johnkok/mpm/PCB/MPM/pm.kicad_pcb

## KiCad design PCB/MPM/pm.kicad_pcb (2024-08-20)

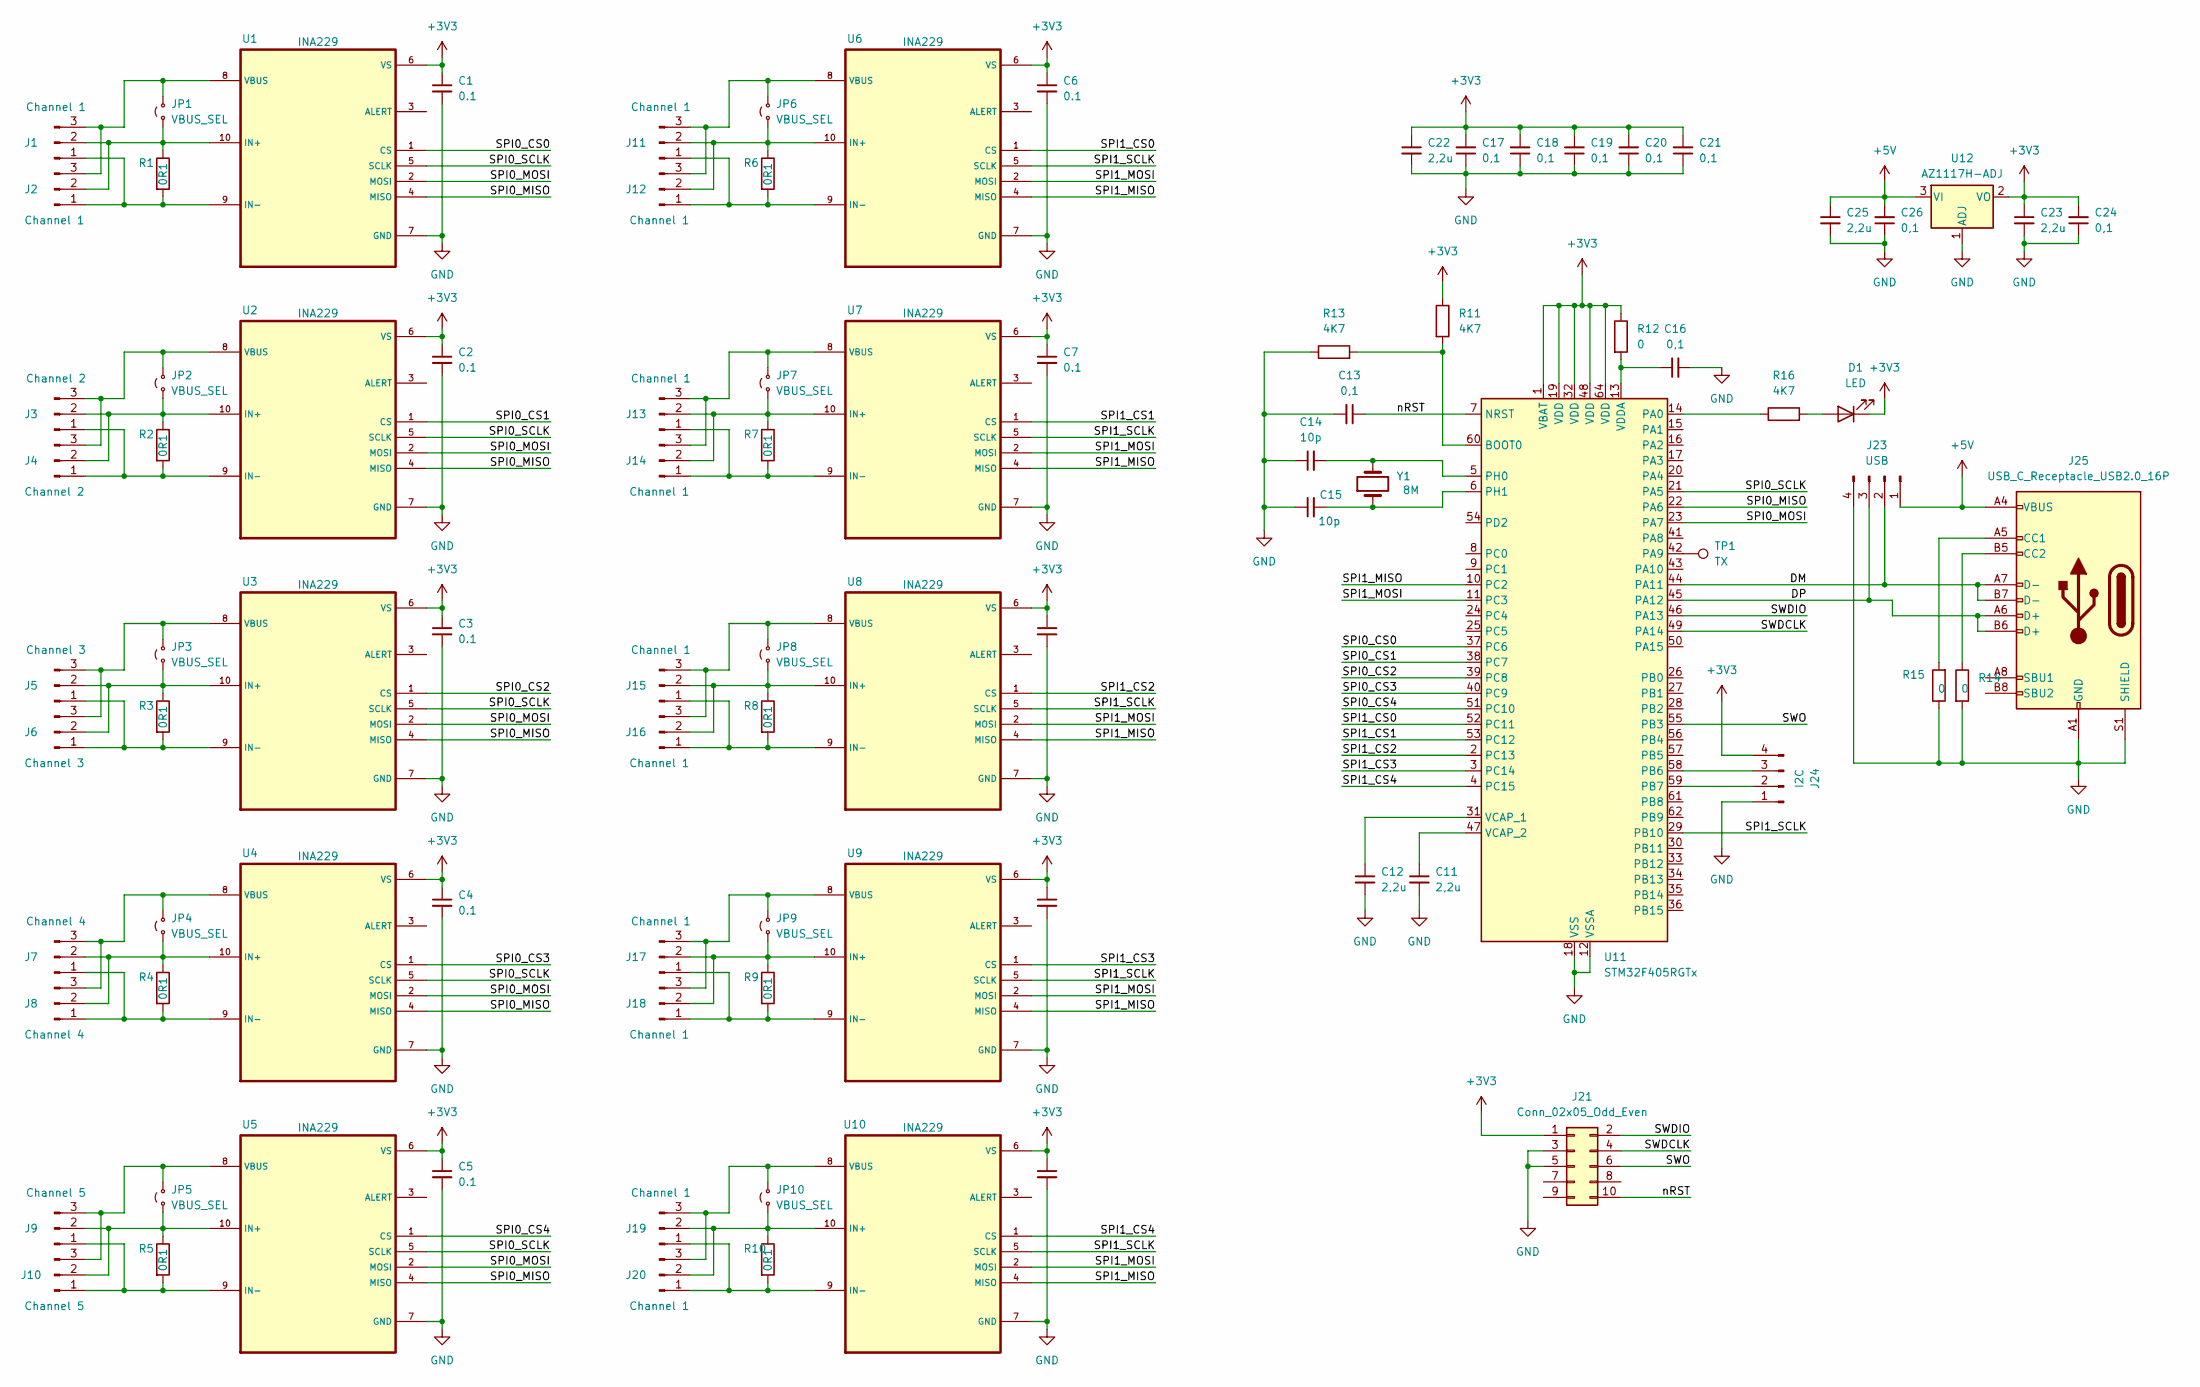
[picture p1: schematic pm.kicad_sch]

Parts:
C1, C2, C3, C4, C5, C6, C7, C8, C9, C10: 0.1; C_0603_1608Metric_Pad1.08x0.95mm_HandSolder
C11, C12, C22, C23, C25: 2,2u; C_0805_2012Metric_Pad1.18x1.45mm_HandSolder
C13, C16, C17, C18, C19, C20, C21, C24, C26: 0,1; C_0603_1608Metric_Pad1.08x0.95mm_HandSolder
C14, C15: 10p; C_0603_1608Metric_Pad1.08x0.95mm_HandSolder
D1: LED; LED_0603_1608Metric
J1, J11, J13, J15, J17, J19: Channel 1; PinHeader_1x03_P2.54mm_Vertical
J2, J12, J14, J16, J18, J20: Channel 1; PhoenixContact_MCV_1,5_3-G-5.08_1x03_P5.08mm_Vertical
J3: Channel 2; PinHeader_1x03_P2.54mm_Vertical
J4: Channel 2; PhoenixContact_MCV_1,5_3-G-5.08_1x03_P5.08mm_Vertical
J5: Channel 3; PinHeader_1x03_P2.54mm_Vertical
J6: Channel 3; PhoenixContact_MCV_1,5_3-G-5.08_1x03_P5.08mm_Vertical
J7: Channel 4; PinHeader_1x03_P2.54mm_Vertical
J8: Channel 4; PhoenixContact_MCV_1,5_3-G-5.08_1x03_P5.08mm_Vertical
J9: Channel 5; PinHeader_1x03_P2.54mm_Vertical
J10: Channel 5; PhoenixContact_MCV_1,5_3-G-5.08_1x03_P5.08mm_Vertical
J21: Conn_02x05_Odd_Even; PinHeader_2x05_P2.54mm_Vertical
J23: USB; PinHeader_1x04_P2.54mm_Vertical
J24: I2C; PinHeader_1x04_P2.54mm_Vertical
J25: USB_C_Receptacle_USB2.0_16P; USB_C_Receptacle_GCT_USB4105-xx-A_16P_TopMnt_Horizontal
JP1, JP2, JP3, JP4, JP5, JP6, JP7, JP8, JP9, JP10: VBUS_SEL; PinHeader_1x02_P2.54mm_Vertical
R1, R2, R3, R4, R5, R6, R7, R8, R9, R10: 0R1; R_1206_3216Metric_Pad1.30x1.75mm_HandSolder
R11, R13, R16: 4K7; R_0603_1608Metric_Pad0.98x0.95mm_HandSolder
R12, R14, R15: 0; R_0603_1608Metric_Pad0.98x0.95mm_HandSolder
TP1: TX; TestPoint_Loop_D1.80mm_Drill1.0mm_Beaded
U1, U2, U3, U4, U5, U6, U7, U8, U9, U10: INA229; VSSOP-10_3x3mm_P0.5mm
U11: STM32F405RGTx; LQFP-64_10x10mm_P0.5mm
U12: AZ1117H-ADJ; SOT-223-3_TabPin2
Y1: 8M; Crystal_HC18-U_Vertical

Connections:
+3V3: C1.1, C2.1, C3.1, C4.1, C5.1, C6.1, C7.1, C8.1, C9.1, C10.1, C17.2, C18.2, C19.2, C20.2, C21.2, C22.1, C23.1, C24.2, D1.1 (K), J21.1, J24.4, R11.1, R12.1, U1.6 (VS), U2.6 (VS), U3.6 (VS), U4.6 (VS), U5.6 (VS), U6.6 (VS), U7.6 (VS), U8.6 (VS), U9.6 (VS), U10.6 (VS), U11.1 (VBAT), U11.19 (VDD), U11.32 (VDD), U11.48 (VDD), U11.64 (VDD), U12.2 (VO)
+5V: C25.1, C26.2, J23.1, J25.A4 (VBUS), J25.A9 (VBUS), J25.B4 (VBUS), J25.B9 (VBUS), U12.3 (VI)
/DM: J23.2, J25.A7 (D-), J25.B7 (D-), U11.44 (PA11)
/DP: J23.3, J25.A6 (D+), J25.B6 (D+), U11.45 (PA12)
/SPI0_CS0: U1.1 (CS), U11.37 (PC6)
/SPI0_CS1: U2.1 (CS), U11.38 (PC7)
/SPI0_CS2: U3.1 (CS), U11.39 (PC8)
/SPI0_CS3: U4.1 (CS), U11.40 (PC9)
/SPI0_CS4: U5.1 (CS), U11.51 (PC10)
/SPI0_MISO: U1.4 (MISO), U2.4 (MISO), U3.4 (MISO), U4.4 (MISO), U5.4 (MISO), U11.22 (PA6)
/SPI0_MOSI: U1.2 (MOSI), U2.2 (MOSI), U3.2 (MOSI), U4.2 (MOSI), U5.2 (MOSI), U11.23 (PA7)
/SPI0_SCLK: U1.5 (SCLK), U2.5 (SCLK), U3.5 (SCLK), U4.5 (SCLK), U5.5 (SCLK), U11.21 (PA5)
/SPI1_CS0: U6.1 (CS), U11.52 (PC11)
/SPI1_CS1: U7.1 (CS), U11.53 (PC12)
/SPI1_CS2: U8.1 (CS), U11.2 (PC13)
/SPI1_CS3: U9.1 (CS), U11.3 (PC14)
/SPI1_CS4: U10.1 (CS), U11.4 (PC15)
/SPI1_MISO: U6.4 (MISO), U7.4 (MISO), U8.4 (MISO), U9.4 (MISO), U10.4 (MISO), U11.10 (PC2)
/SPI1_MOSI: U6.2 (MOSI), U7.2 (MOSI), U8.2 (MOSI), U9.2 (MOSI), U10.2 (MOSI), U11.11 (PC3)
/SPI1_SCLK: U6.5 (SCLK), U7.5 (SCLK), U8.5 (SCLK), U9.5 (SCLK), U10.5 (SCLK), U11.29 (PB10)
/SWDCLK: J21.4, U11.49 (PA14)
/SWDIO: J21.2, U11.46 (PA13)
/SWO: J21.6, U11.55 (PB3)
/nRST: C13.1, J21.10, U11.7 (NRST)
GND: C1.2, C2.2, C3.2, C4.2, C5.2, C6.2, C7.2, C8.2, C9.2, C10.2, C11.2, C12.2, C13.2, C14.1, C15.1, C16.2, C17.1, C18.1, C19.1, C20.1, C21.1, C22.2, C23.2, C24.1, C25.2, C26.1, J21.3, J21.5, J23.4, J24.1, J25.A1 (GND), J25.A12 (GND), J25.B1 (GND), J25.B12 (GND), J25.S1 (SHIELD), R13.1, R14.2, R15.1, U1.7 (GND), U2.7 (GND), U3.7 (GND), U4.7 (GND), U5.7 (GND), U6.7 (GND), U7.7 (GND), U8.7 (GND), U9.7 (GND), U10.7 (GND), U11.12 (VSSA), U11.18 (VSS), U11.63 (VSS), U12.1 (ADJ)
unnamed: D1.2 (A), R16.2
unnamed: J1.1, J2.1, R1.2, U1.9 (IN-)
unnamed: J1.2, J2.2, JP1.1 (A), R1.1, U1.10 (IN+)
unnamed: J1.3, J2.3, JP1.2 (B), U1.8 (VBUS)
unnamed: J3.1, J4.1, R2.2, U2.9 (IN-)
unnamed: J3.2, J4.2, JP2.1 (A), R2.1, U2.10 (IN+)
unnamed: J3.3, J4.3, JP2.2 (B), U2.8 (VBUS)
unnamed: J5.1, J6.1, R3.2, U3.9 (IN-)
unnamed: J5.2, J6.2, JP3.1 (A), R3.1, U3.10 (IN+)
unnamed: J5.3, J6.3, JP3.2 (B), U3.8 (VBUS)
unnamed: J7.1, J8.1, R4.2, U4.9 (IN-)
unnamed: J7.2, J8.2, JP4.1 (A), R4.1, U4.10 (IN+)
unnamed: J7.3, J8.3, JP4.2 (B), U4.8 (VBUS)
unnamed: J9.1, J10.1, R5.2, U5.9 (IN-)
unnamed: J9.2, J10.2, JP5.1 (A), R5.1, U5.10 (IN+)
unnamed: J9.3, J10.3, JP5.2 (B), U5.8 (VBUS)
unnamed: J11.1, J12.1, R6.2, U6.9 (IN-)
unnamed: J11.2, J12.2, JP6.1 (A), R6.1, U6.10 (IN+)
unnamed: J11.3, J12.3, JP6.2 (B), U6.8 (VBUS)
unnamed: J13.1, J14.1, R7.2, U7.9 (IN-)
unnamed: J13.2, J14.2, JP7.1 (A), R7.1, U7.10 (IN+)
unnamed: J13.3, J14.3, JP7.2 (B), U7.8 (VBUS)
unnamed: J15.1, J16.1, R8.2, U8.9 (IN-)
unnamed: J15.2, J16.2, JP8.1 (A), R8.1, U8.10 (IN+)
unnamed: J15.3, J16.3, JP8.2 (B), U8.8 (VBUS)
unnamed: J17.1, J18.1, R9.2, U9.9 (IN-)
unnamed: J17.2, J18.2, JP9.1 (A), R9.1, U9.10 (IN+)
unnamed: J17.3, J18.3, JP9.2 (B), U9.8 (VBUS)
unnamed: J19.1, J20.1, R10.2, U10.9 (IN-)
unnamed: J19.2, J20.2, JP10.1 (A), R10.1, U10.10 (IN+)
unnamed: J19.3, J20.3, JP10.2 (B), U10.8 (VBUS)
unnamed: J24.2, U11.59 (PB7)
unnamed: J24.3, U11.58 (PB6)
unnamed: J25.A5 (CC1), R15.2
unnamed: J25.B5 (CC2), R14.1
unnamed: R11.2, R13.2, U11.60 (BOOT0)
unnamed: R16.1, U11.14 (PA0)
unnamed: TP1.1, U11.42 (PA9)
unnamed: C14.2, U11.5 (PH0), Y1.2
unnamed: C15.2, U11.6 (PH1), Y1.1
unnamed: C12.1, U11.31 (VCAP_1)
unnamed: C11.1, U11.47 (VCAP_2)
unnamed: C16.1, R12.2, U11.13 (VDDA)

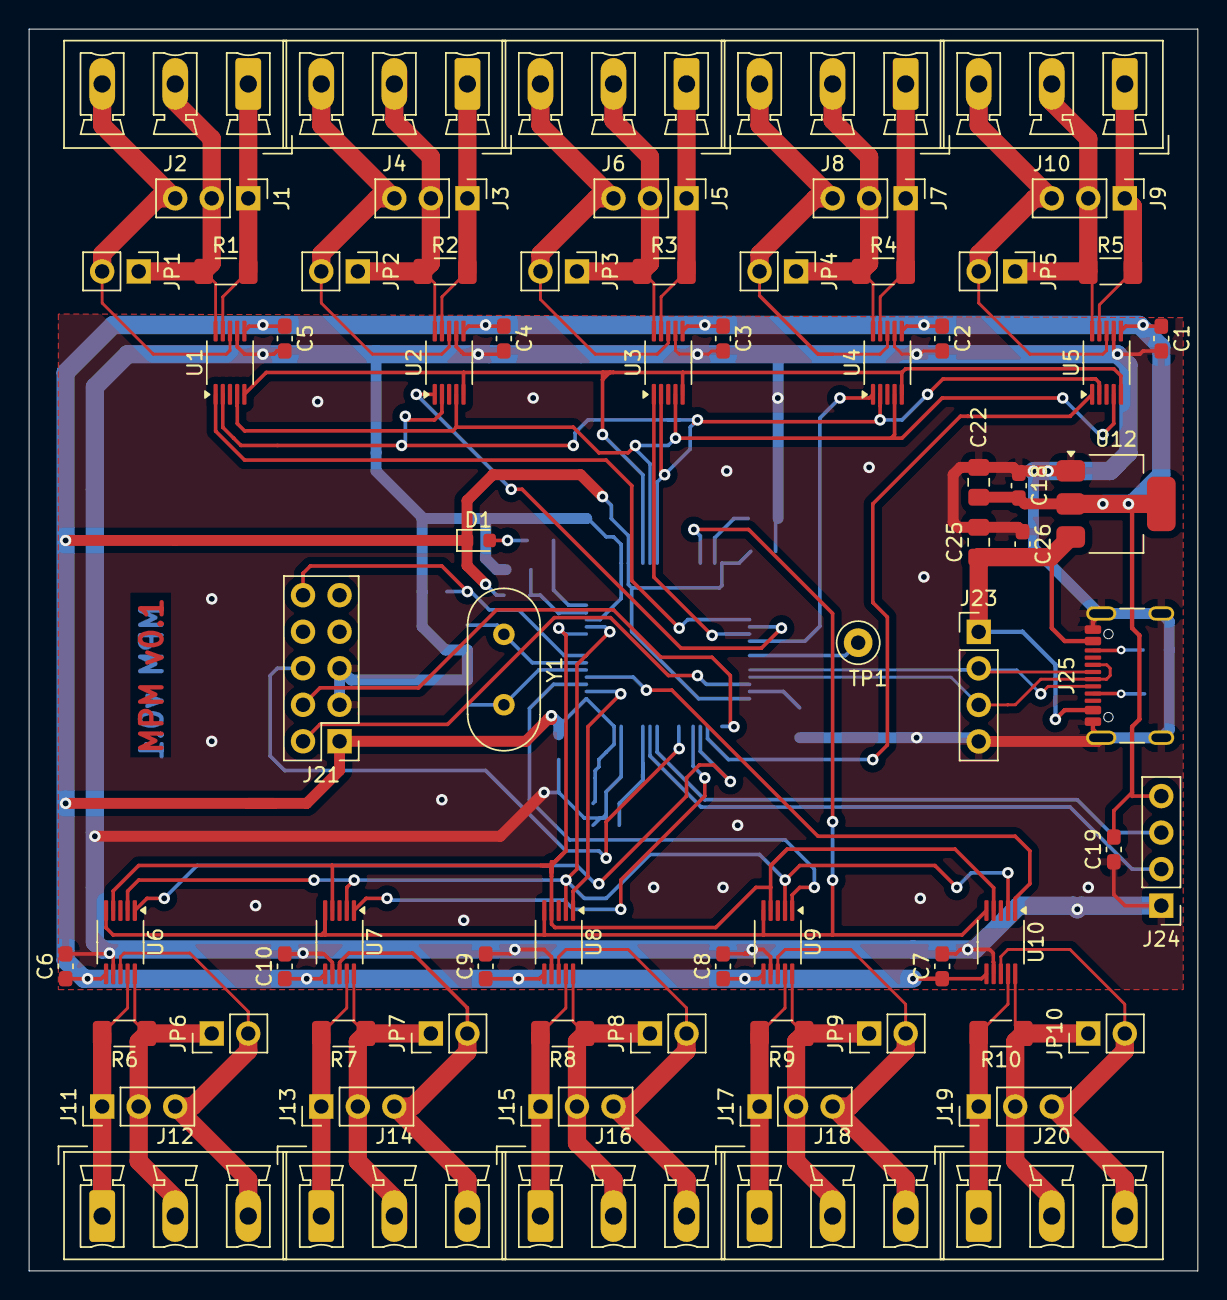
[picture p2: board pm.kicad_pcb from above]

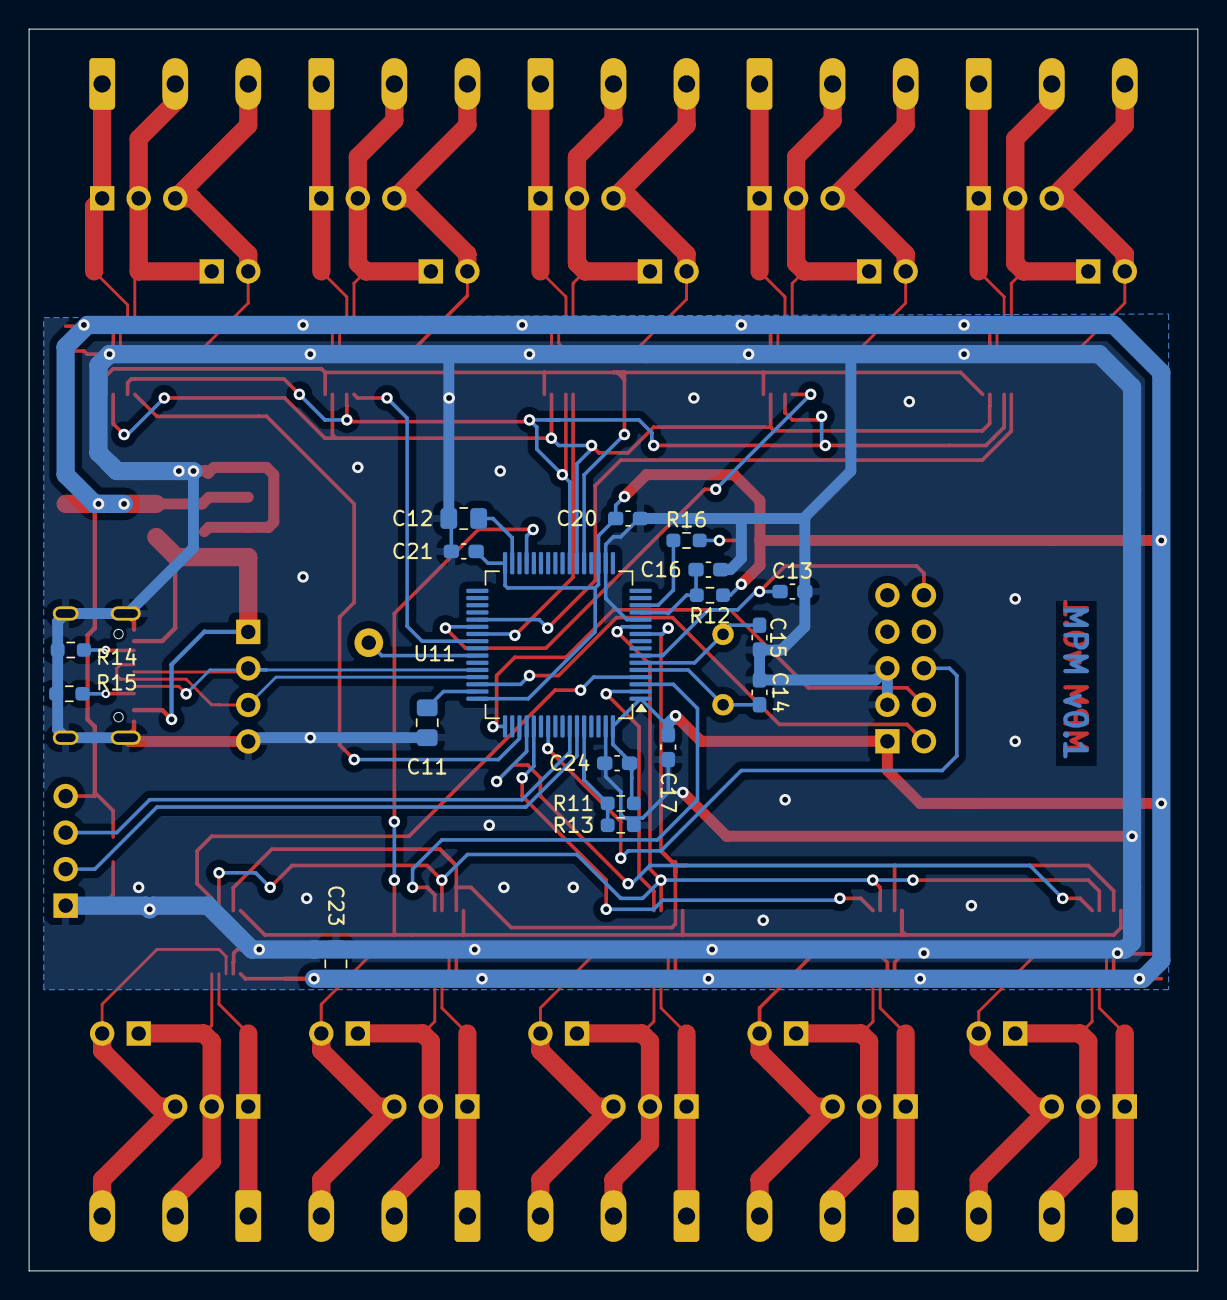
[picture p3: board pm.kicad_pcb from below]

Board: 2 copper layers, 81.3 x 86.4 mm, 91 parts (18 on the bottom side), 68 nets.
