johnkok/mpm/FW2/Core/Src/main.c

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
/* Includes ------------------------------------------------------------------*/
#include "main.h"
#include "cmsis_os.h"
#include "usb_device.h"

I2C_HandleTypeDef hi2c1;

SPI_HandleTypeDef hspi1;
SPI_HandleTypeDef hspi2;

UART_HandleTypeDef huart1;
DMA_HandleTypeDef hdma_usart1_rx;

/* Definitions for defaultTask */
osThreadId_t defaultTaskHandle;
const osThreadAttr_t defaultTask_attributes = {
  .name = "defaultTask",
  .stack_size = 256 * 4,
  .priority = (osPriority_t) osPriorityNormal,
};
/* Definitions for IdleTask */
osThreadId_t IdleTaskHandle;
const osThreadAttr_t IdleTask_attributes = {
  .name = "IdleTask",
  .stack_size = 256 * 4,
  .priority = (osPriority_t) osPriorityLow,
};
/* Definitions for MeasTask */
osThreadId_t MeasTaskHandle;
const osThreadAttr_t MeasTask_attributes = {
  .name = "MeasTask",
  .stack_size = 256 * 4,
  .priority = (osPriority_t) osPriorityLow,
};
/* Definitions for DisplayTask */
osThreadId_t DisplayTaskHandle;
const osThreadAttr_t DisplayTask_attributes = {
  .name = "DisplayTask",
  .stack_size = 256 * 4,
  .priority = (osPriority_t) osPriorityLow,
};
/* Definitions for SysTask */
osThreadId_t SysTaskHandle;
const osThreadAttr_t SysTask_attributes = {
  .name = "SysTask",
  .stack_size = 256 * 4,
  .priority = (osPriority_t) osPriorityLow,
};
void SystemClock_Config(void);
static void MX_GPIO_Init(void);
static void MX_DMA_Init(void);
static void MX_SPI1_Init(void);
static void MX_SPI2_Init(void);
static void MX_USART1_UART_Init(void);
static void MX_I2C1_Init(void);
void StartDefaultTask(void *argument);
void IdleTaskEntry(void *argument);
void MeasTaskEntry(void *argument);
void DisplayTaskEntry(void *argument);
void SysTaskEntry(void *argument);

/**
  * @brief  The application entry point.
  * @retval int
  */
int main(void)
{

  /* MCU Configuration--------------------------------------------------------*/

  /* Reset of all peripherals, Initializes the Flash interface and the Systick. */
  HAL_Init();

  /* Configure the system clock */
  SystemClock_Config();

  /* Initialize all configured peripherals */
  MX_GPIO_Init();
  MX_DMA_Init();
  MX_SPI1_Init();
  MX_SPI2_Init();
  MX_USART1_UART_Init();
  MX_I2C1_Init();
  /* Init scheduler */
  osKernelInitialize();

  /* USER CODE BEGIN RTOS_MUTEX */
  /* add mutexes, ... */
  /* USER CODE END RTOS_MUTEX */

  /* USER CODE BEGIN RTOS_SEMAPHORES */
  /* add semaphores, ... */
  /* USER CODE END RTOS_SEMAPHORES */

  /* USER CODE BEGIN RTOS_TIMERS */
  /* start timers, add new ones, ... */
  /* USER CODE END RTOS_TIMERS */

  /* USER CODE BEGIN RTOS_QUEUES */
  /* add queues, ... */
  /* USER CODE END RTOS_QUEUES */

  /* Create the thread(s) */
  /* creation of defaultTask */
  defaultTaskHandle = osThreadNew(StartDefaultTask, NULL, &defaultTask_attributes);

  /* creation of IdleTask */
  IdleTaskHandle = osThreadNew(IdleTaskEntry, NULL, &IdleTask_attributes);

  /* creation of MeasTask */
  MeasTaskHandle = osThreadNew(MeasTaskEntry, NULL, &MeasTask_attributes);

  /* creation of DisplayTask */
  DisplayTaskHandle = osThreadNew(DisplayTaskEntry, NULL, &DisplayTask_attributes);

  /* creation of SysTask */
  SysTaskHandle = osThreadNew(SysTaskEntry, NULL, &SysTask_attributes);

  /* USER CODE BEGIN RTOS_THREADS */
  /* add threads, ... */
  /* USER CODE END RTOS_THREADS */

  /* USER CODE BEGIN RTOS_EVENTS */
  /* add events, ... */
  /* USER CODE END RTOS_EVENTS */

  /* Start scheduler */
  osKernelStart();

  /* We should never get here as control is now taken by the scheduler */

  /* Infinite loop */
  /* USER CODE BEGIN WHILE */
  while (1)
  {
    /* USER CODE END WHILE */

    /* USER CODE BEGIN 3 */
  }
  /* USER CODE END 3 */
}

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
/* USER CODE BEGIN Header_StartDefaultTask */
/**
  * @brief  Function implementing the defaultTask thread.
  * @param  argument: Not used
  * @retval None
  */
/* USER CODE END Header_StartDefaultTask */
void StartDefaultTask(void *argument)
{
  /* init code for USB_DEVICE */
  MX_USB_DEVICE_Init();
  /* USER CODE BEGIN 5 */
  /* Infinite loop */
  for(;;)
  {
    osDelay(1000);
  }
  /* USER CODE END 5 */
}

/* USER CODE BEGIN Header_IdleTaskEntry */
/**
* @brief Function implementing the IdleTask thread.
* @param argument: Not used
* @retval None
*/
/* USER CODE END Header_IdleTaskEntry */
void IdleTaskEntry(void *argument)
{
  /* USER CODE BEGIN IdleTaskEntry */
  /* Infinite loop */
  for(;;)
  {
    osDelay(500);
    HAL_GPIO_TogglePin(LED_GPIO_Port, LED_Pin);
  }
  /* USER CODE END IdleTaskEntry */
}

/* USER CODE BEGIN Header_MeasTaskEntry */
/**
* @brief Function implementing the MeasTask thread.
* @param argument: Not used
* @retval None
*/
/* USER CODE END Header_MeasTaskEntry */
void MeasTaskEntry(void *argument)
{
  /* USER CODE BEGIN MeasTaskEntry */

  InitAllIna(hspi1, hspi2);

  /* Infinite loop */
  for(;;)
  {
    osDelay(100);
    CDC_Transmit_FS("Meas task running\n\r", sizeof("Meas task running\n\r"));
    ReadAll_A(hspi1);
    ReadAll_B(hspi2);

  }
  /* USER CODE END MeasTaskEntry */
}

/* USER CODE BEGIN Header_DisplayTaskEntry */
/**
* @brief Function implementing the DisplayTask thread.
* @param argument: Not used
* @retval None
*/
/* USER CODE END Header_DisplayTaskEntry */
void DisplayTaskEntry(void *argument)
{
  /* USER CODE BEGIN DisplayTaskEntry */
  /* Infinite loop */
  for(;;)
  {
    osDelay(100);
  }
  /* USER CODE END DisplayTaskEntry */
}

/* USER CODE BEGIN Header_SysTaskEntry */
/**
* @brief Function implementing the SysTask thread.
* @param argument: Not used
* @retval None
*/
/* USER CODE END Header_SysTaskEntry */
void SysTaskEntry(void *argument)
{
  /* USER CODE BEGIN SysTaskEntry */
  /* Infinite loop */
  for(;;)
  {
    osDelay(1000);
  }
  /* USER CODE END SysTaskEntry */
}

/**
  * @brief  Period elapsed callback in non blocking mode
  * @note   This function is called  when TIM2 interrupt took place, inside
  * HAL_TIM_IRQHandler(). It makes a direct call to HAL_IncTick() to increment
  * a global variable "uwTick" used as application time base.
  * @param  htim : TIM handle
  * @retval None
  */
void HAL_TIM_PeriodElapsedCallback(TIM_HandleTypeDef *htim)
{
  if (htim->Instance == TIM2) {
    HAL_IncTick();
  }
}

/**
  * @brief  This function is executed in case of error occurrence.
  * @retval None
  */
void Error_Handler(void)
{
  /* USER CODE BEGIN Error_Handler_Debug */
  /* User can add his own implementation to report the HAL error return state */
  __disable_irq();
  while (1)
  {
  }
  /* USER CODE END Error_Handler_Debug */
}

#ifdef  USE_FULL_ASSERT
/**
  * @brief  Reports the name of the source file and the source line number
  *         where the assert_param error has occurred.
  * @param  file: pointer to the source file name
  * @param  line: assert_param error line source number
  * @retval None
  */
void assert_failed(uint8_t *file, uint32_t line)
{
  /* USER CODE BEGIN 6 */
  /* User can add his own implementation to report the file name and line number,
     ex: printf("Wrong parameters value: file %s on line %d\r\n", file, line) */
  /* USER CODE END 6 */
}
#endif /* USE_FULL_ASSERT */
