johnkok/mpm/FW2/Core/Inc/main.h

#define nCS_B2_Pin GPIO_PIN_13
#define nCS_B2_GPIO_Port GPIOC
#define nCS_B3_Pin GPIO_PIN_14
#define nCS_B3_GPIO_Port GPIOC
#define nCS_B4_Pin GPIO_PIN_15
#define nCS_B4_GPIO_Port GPIOC
#define LED_Pin GPIO_PIN_0
#define LED_GPIO_Port GPIOA
#define nCS_A0_Pin GPIO_PIN_6
#define nCS_A0_GPIO_Port GPIOC
#define nCS_A1_Pin GPIO_PIN_7
#define nCS_A1_GPIO_Port GPIOC
#define nCS_A2_Pin GPIO_PIN_8
#define nCS_A2_GPIO_Port GPIOC
#define nCS_A3_Pin GPIO_PIN_9
#define nCS_A3_GPIO_Port GPIOC
#define nCS_A4_Pin GPIO_PIN_10
#define nCS_A4_GPIO_Port GPIOC
#define nCS_B0_Pin GPIO_PIN_11
#define nCS_B0_GPIO_Port GPIOC
#define nCS_B1_Pin GPIO_PIN_12
#define nCS_B1_GPIO_Port GPIOC
